Vanperdung/Project_2/README.md

# PROJECT 2 - SMARTHOME
## DEV - [VANPERDUNG](https://www.facebook.com/vanperdung)
