Vanperdung/Project_2/Firmware/Note.txt

Phân biệt chức năng của thiết bị khi Provisioning?
 => How can Provisioner get and parse the Composition Data of nodes through Configuration Client Model?
