Vanperdung/Project_2/Doc/Model.docx

### 1.1. Time Server

Time Server model là root model, khi Time Server model ở một element thì Time Setup Server model cũng phải ở element đó.

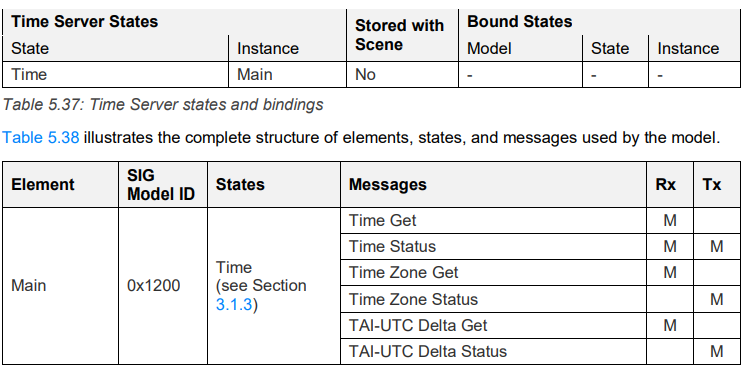
[picture p28: figure]

### 1.2. Time Setup Server

Time Setup Server
