Vanperdung/Project_2/Doc/315151084_661071245694561_7688606577452205725_n.png

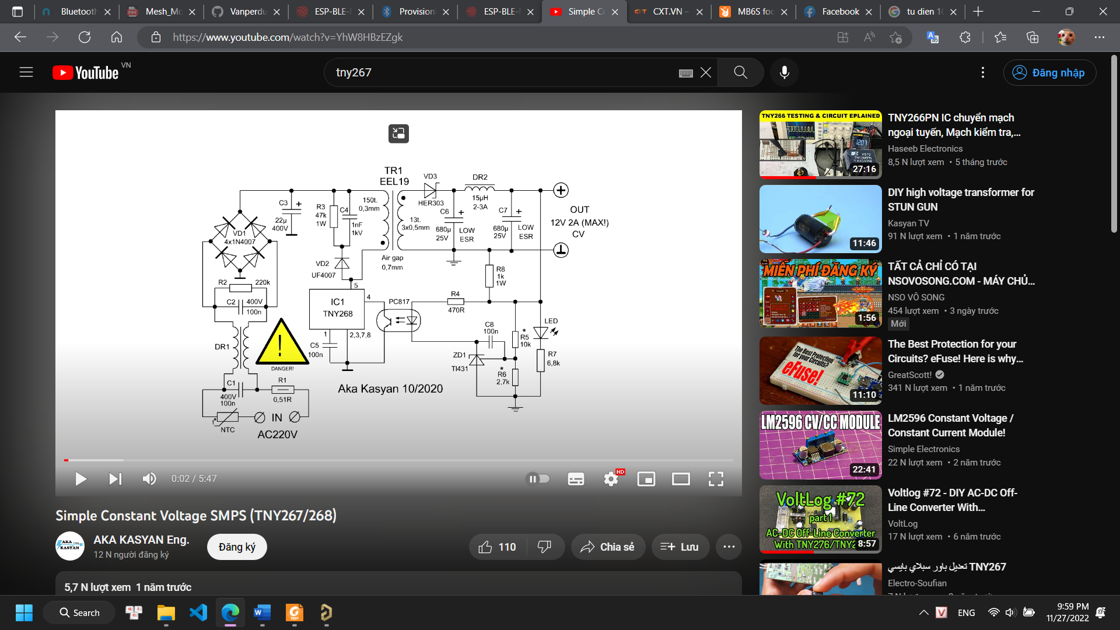
Doc/315151084_661071245694561_7688606577452205725_n.png
