Vanperdung/Project_2/Doc/318385985_421443116750344_1208361178294182225_n.jpg

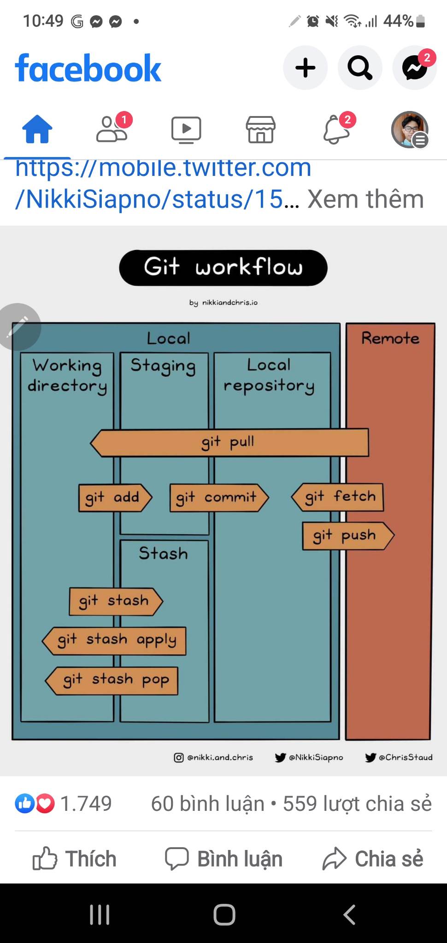
Doc/318385985_421443116750344_1208361178294182225_n.jpg
