Vanperdung/Project_2/Doc/Screenshot 2022-12-20 124549.png

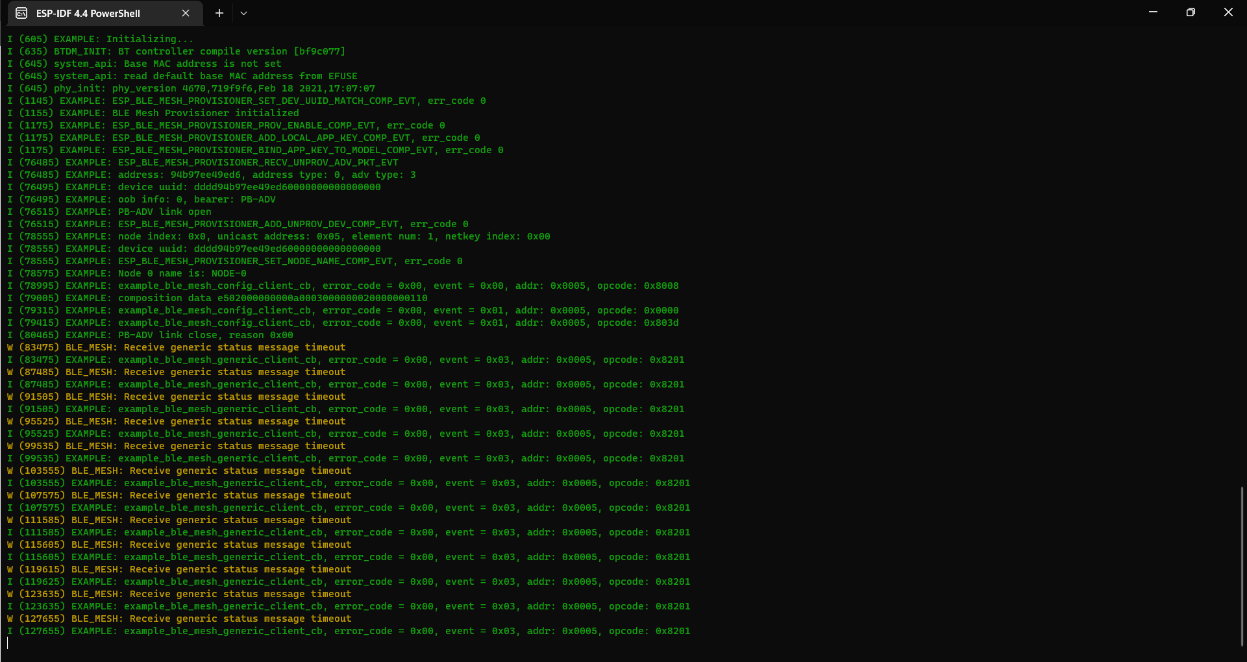
Doc/Screenshot 2022-12-20 124549.png
