Vanperdung/Project_2/Doc/Screenshot 2022-12-20 130242.png

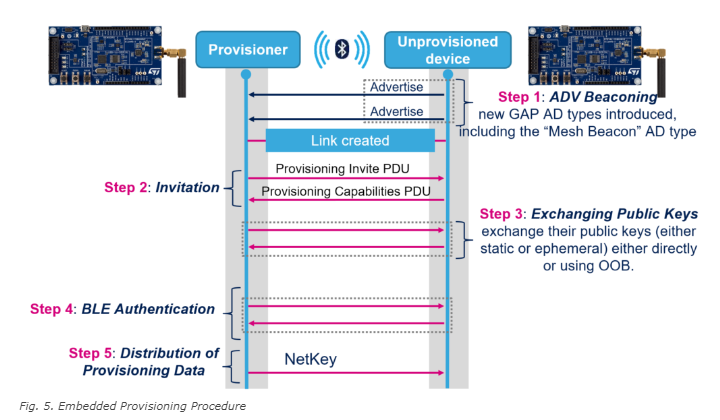
Doc/Screenshot 2022-12-20 130242.png
