Vanperdung/Project_2/Doc/Screenshot 2022-12-21 164502.png

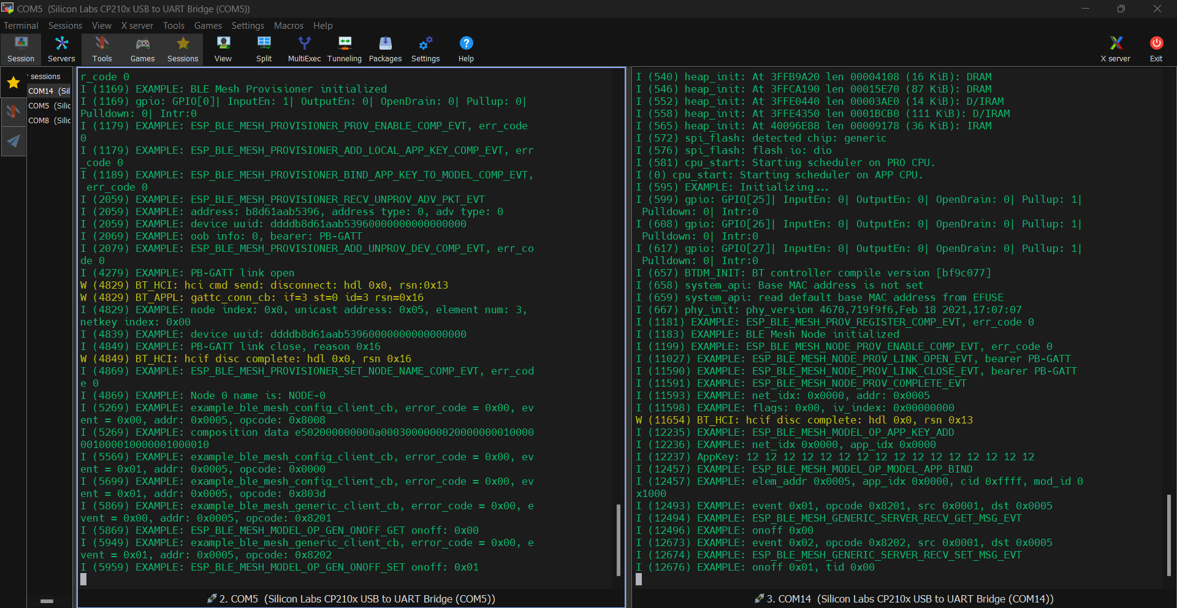
Doc/Screenshot 2022-12-21 164502.png
