Vanperdung/Project_2/Hardware/SmartSwitchV3/Project Outputs for SmartSwitchV3/SmartSwitchV3.xlsx

Comment | Description | Designator | Footprint | LibRef | Quantity
Button 3x4x2.5 |  | B1, B2 | Button 3x4x2.5 | Button 3x4x2.5 | 2
10uF/400V | Polarized Capacitor (Axial) | C1 | C10mm | Cap Pol | 1
1nF/400V | CAP CERAMIC | C2 | 103/2KV | Cap2KV | 1
680uF/16V | Polarized Capacitor (Axial) | C3 | C8mm | Cap Pol | 1
470uF/16V | Polarized Capacitor (Axial) | C4 | C8mm | Cap Pol | 1
0.1uF/275v | Tụ lọc nguồn AC 0.1uf 275v 10mm | C5 | Cap AC filter | Cap AC filter | 1
14D471K | Capacitor Ceramic 2KV | C6 | 103/2KV | Cap2KV | 1
100nF | Capacitor | C7, C8, C9, C11, C13, C15, C18 | CAP_0805 | CapSMD | 7
10uF | Capacitor | C10, C12, C14, C19 | CAP_0805 | CapSMD | 4
30pF | Capacitor | C16, C17, C20, C21 | CAP_0805 | CapSMD | 4
SS14 | Diode Schottky 1N5819 | D1 | DO-214AA(SMB) | Diode SMD | 1
1N4937 | Diode Schottky 1N4937 | D2 | DIO-1AN | Diode SMD | 1
M7 | Dán | D3, D4, D5, D6 | DIODE SMA | Diode M7 ( 4007 ) | 4
TNY264 | IC Power | IC1 | TNY264 | TNY264 | 1
TL431 | Programmable Shunt Regulator | IC2 | qto-92 | TL431 | 1
TTP224 |  | IC3 | TTP224 | TTP224 | 1
Coc_dong |  | JP1, JP2, JP3, JP4, JP5, JP6 | Coc_dong | Coc_dong | 6
Inductor EE8.3 |  | L1 | Inductor EE8.3 | Inductor EE8.3 | 1
22uH | CD73R 22uH 1.23A 7345 | L2 | L_SMD | Inductor | 1
LED | LED Single colour Green and Red | LED1, LED2, LED3, LED4, LED5 | LED-0805-Red | LED | 5
C1815 | NPN 600mW, ECB | Q1, Q2 | SOT23D | 2SC1815 | 2
2N2222 | NPN transistor | Q3, Q4, Q5, Q6 | SOT23 | C1815 HF SMD | 4
200k/2W | Resistor | R1 | RES-1WW | Resistor - SMD | 1
1k | Resistor | R2, R13, R14, R16, R17, R18, R19, R20, R21 | RES-SMD-0805 | Resistor - SMD | 9
1M | Resistor | R3, R4 | RES-SMD-1206 | Resistor - SMD | 2
200R | Resistor | R5 | RES-SMD-0805 | Resistor - SMD | 1
3.3k | Resistor | R6 | RES-SMD-0805 | Resistor - SMD | 1
11k | Resistor | R7 | RES-SMD-0805 | Resistor - SMD | 1
2R/2W | Resistor | R8 | RES-1WW | Resistor - SMD | 1
10k | Resistor | R9, R10, R11, R12, R15 | RES-SMD-0805 | Resistor - SMD | 5
Relay_HF32 |  | RL1, RL2, RL3, RL4 | HF32F | Relay_HF32 | 4
Transformer EE12.7 |  | Transf1 | Transformer EE12.7 | Tranformer EE16 | 1
Diode Bridge Flate | Diode Bridge | U1 | DB207S | Diode Bridge Flate | 1
OPTO PC817 SMD | Single Opto | U2 | SOP4 | OPTO PC817 SMD | 1
ESP32-WROOM-32 | Bluetooth, WiFi Transceiver Module 2.4GHz ~ 2.5GHz Surface Mount | U3 | MODULE_ESP32-WROOM-32 | ESP32-WROOM-32 | 1
CH340C | USB to serial chip CH340 | U4 | SO016 | CH340C | 1
LM1117-ADJ | 800mA Low-Dropout Linear Regulator | U5 | LM1117-SOP | LM1117-ADJ | 1
USB Micro 5p DIP | USB Type B | USB1, USB2 | USB Micro 5p DIP | USB Micro 5p DIP | 2
