Vanperdung/Project_2/Hardware/GatewayV2/Project Outputs for GatewayV2/GatewayV2.xlsx

Comment | Description | Designator | Footprint | LibRef | Quantity
ANTENA | Generic Antenna | AN1 | DE ANTEN SMA CONG | ANTEN SMA CONG | 1
Button 3x4x2.5 |  | B1, B2, B3 | Button 3x4x2.5 | Button 3x4x2.5 | 3 | x
10uF | Capacitor | C1, C3, C6 | CAP_0805 | CapSMD | 3 | x
100nF | Capacitor | C2, C4, C5, C13, C14 | CAP_0805 | CapSMD | 5 | x
10uF/400V | Polarized Capacitor (Axial) | C7 | C10mm | Cap Pol | 1 | x
1nF/400V | CAP CERAMIC | C8 | 103/2KV | Cap2KV | 1 | x
14D471K | Capacitor Ceramic 2KV | C9 | 103/2KV | Cap2KV | 1 | x
0.1uF/275v | Tụ lọc nguồn AC 0.1uf 275v 10mm | C10 | Cap AC filter | Cap AC filter | 1 | x
680uF/16V | Polarized Capacitor (Axial) | C11 | C8mm | Cap Pol | 1 | x
470uF/16V | Polarized Capacitor (Axial) | C12 | C8mm | Cap Pol | 1 | x
SS14 | Diode Schottky 1N5819 | D1 | DO-214AC(SMA) | Diode SMD | 1 | x
1N4937 | Diode Schottky 1N4937 | D2 | DIO-1AN | Diode SMD | 1 | x
MB6S |  | IC1 | MB6S | MB6S | 1 | x
TNY264 | IC Power | IC2 | TNY264 | TNY264 | 1 | x
TL431 | Programmable Shunt Regulator | IC3 | qto-92 | TL431 | 1 | x
KF2 |  | J1 | KF2-5.08T | KF2 | 1 | x
Inductor EE8.3 |  | L1 | Inductor EE8.3 | Inductor EE8.3 | 1 | x
22uH | CD73R 22uH 1.23A 7345 | L2 | L_SMD | Inductor | 1 | x
LED | LED Single colour Green and Red | LED1, LED2, LED3 | LED-0805-Red | LED | 3 | x
C1815 | NPN 600mW, ECB | Q1, Q2 | SOT23D | 2SC1815 | 2 | x
10k | Resistor | R1, R2, R4, R6, R7, R16 | RES-SMD-0805 | Resistor - SMD | 6 | x
1k | Resistor | R3, R5, R12 | RES-SMD-0805 | Resistor - SMD | 3 | x
2R/2W | Resistor | R8 | RES-1WW | Resistor - SMD | 1 | x
1M | Resistor | R9, R11 | RES-SMD-1206 | Resistor - SMD | 2 | x
200k/2W | Resistor | R10 | RES-1WW | Resistor - SMD | 1 | x
200R | Resistor | R13 | RES-SMD-0805 | Resistor - SMD | 1 | x
3.3k | Resistor | R14 | RES-SMD-0805 | Resistor - SMD | 1 | x
11k | Resistor | R15 | RES-SMD-0805 | Resistor - SMD | 1
Transformer EE12.7 |  | Transf1 | Transformer EE12.7 | Tranformer EE16 | 1
LM1117-ADJ | 800mA Low-Dropout Linear Regulator | U1 | LM1117-SOP | LM1117-ADJ | 1 | x
ESP32-WROOM-32 | Bluetooth, WiFi Transceiver Module 2.4GHz ~ 2.5GHz Surface Mount | U2 | MODULE_ESP32-WROOM-32 | ESP32-WROOM-32 | 1
CH340C | USB to serial chip CH340 | U3 | SO016 | CH340C | 1 | x
OPTO PC817 SMD | Single Opto | U4 | SOP4 | OPTO PC817 SMD | 1 | x
USB Micro 5p DIP | USB Type B | USB1 | USB Micro 5p DIP | USB Micro 5p DIP | 1 | x
