Vanperdung/Project_2/(list of files, drawings)

Other design files:
Hardware/Gateway/ES8388.SchDoc
Hardware/Gateway/ESP32.SchDoc
Hardware/Gateway/Gateway.PrjPcb
Hardware/Gateway/GatewayV1.PcbDoc
Hardware/Gateway/Power.SchDoc
Hardware/GatewayV2/ESP32.SchDoc
Hardware/GatewayV2/GatewayV2.PrjPcb
Hardware/GatewayV2/Power.SchDoc
Hardware/SmartSwitchV3/SmartSwitchV3.PcbDoc
Hardware/SmartSwitchV3/SmartSwitchV3.PrjPcb
Hardware/SmartSwitchV3/SmartSwitchV3.SchDoc
Hardware/Switch/Switch.PcbDoc
Hardware/Switch/Switch.PcbLib
Hardware/Switch/Switch.PrjPcb
Hardware/Switch/Switch.SchDoc
Hardware/Switch/Switch_V1.PcbDoc
Hardware/Switch_MCU/ESP32.SchDoc
Hardware/Switch_MCU/MCU.PcbDoc
Hardware/Switch_MCU/Switch_MCU.PrjPcb
Hardware/Switch_MCU/TPS5430.SchDoc
Hardware/Switch_MCU/TTP224.SchDoc
Hardware/SwitchV2/Switch.SchDoc
Hardware/SwitchV2/SwitchV2.PcbDoc
Hardware/SwitchV2/SwitchV2.PrjPcb
Hardware/Test/PCB2.PcbDoc
Hardware/Test/Sheet1.SchDoc
Hardware/Test/Sheet2.SchDoc
Hardware/Test/Test.PrjPcb
