Vanperdung/Project_2/Firmware/gateway/main/fota.c

/**
 * @file fota.c
 * @author Vanperdung (dung.nv382001@gmail.com)
 * @brief
 * @version 0.1
 * @date 2023-01-03
 *
 * @copyright Copyright (c) 2023
 *
 */

#include "freertos/FreeRTOS.h"
#include "freertos/task.h"
#include "freertos/event_groups.h"
#include "freertos/queue.h"
#include "freertos/ringbuf.h"
#include "freertos/semphr.h"

#include "nvs_flash.h"

#include "esp_ble_mesh_defs.h"
#include "esp_ble_mesh_common_api.h"
#include "esp_ble_mesh_provisioning_api.h"
#include "esp_ble_mesh_networking_api.h"
#include "esp_ble_mesh_config_model_api.h"
#include "esp_ble_mesh_generic_model_api.h"
#include "esp_log.h"
#include "esp_bt.h"
#include "esp_bt_main.h"
#include "esp_gap_ble_api.h"
#include "esp_bt_device.h"
#include "esp_wifi.h"
#include "esp_smartconfig.h"
#include "mqtt_client.h"
#include "esp_spiffs.h"
#include "esp_ota_ops.h"
#include "esp_http_client.h"
#include "esp_https_ota.h"
#include "esp_tls.h"

#include "driver/gpio.h"

#include "cJSON.h"
#include "mqtt.h"
#include "wifi_sta.h"
#include "button.h"
#include "ble_mesh_user.h"
#include "smartconfig.h"
#include "common.h"
#include "spiffs_user.h"
#include "fota.h"

static const char *TAG = "FOTA";
esp_mqtt_client_handle_t client;
extern char version[10];
extern char topic_commands_set[50];
extern char topic_commands_get[50];
extern char topic_commands_status[50];
extern char topic_commands_heartbeat_node[50];
extern char topic_commands_heartbeat_gateway[50];
extern char topic_commands_network[50];
extern char topic_commands_process[50];
extern char topic_commands_version[50];
extern char topic_commands_fota[50];
extern char topic_commands_group[50];
extern char topic_commands_provision[50];
extern status_red_t status_red;
extern status_blue_t status_blue;

extern const uint8_t github_cert_pem_start[] asm("_binary_git_ota_pem_start");
extern const uint8_t github_cert_pem_end[] asm("_binary_git_ota_pem_end");

esp_err_t ota_event_handler(esp_http_client_event_t *evt)
{
    switch (evt->event_id)
    {
    case HTTP_EVENT_ERROR:
        ESP_LOGD(TAG, "HTTP_EVENT_ERROR");
        break;
    case HTTP_EVENT_ON_CONNECTED:
        ESP_LOGD(TAG, "HTTP_EVENT_ON_CONNECTED");
        break;
    case HTTP_EVENT_HEADER_SENT:
        ESP_LOGD(TAG, "HTTP_EVENT_HEADER_SENT");
        break;
    case HTTP_EVENT_ON_HEADER:
        ESP_LOGD(TAG, "HTTP_EVENT_ON_HEADER, key = %s, value = %s", evt->header_key, evt->header_value);
        break;
    case HTTP_EVENT_ON_DATA:
        ESP_LOGD(TAG, "HTTP_EVENT_ON_DATA, len = %d", evt->data_len);
        break;
    case HTTP_EVENT_ON_FINISH:
        ESP_LOGD(TAG, "HTTP_EVENT_ON_FINISH");
        break;
    case HTTP_EVENT_DISCONNECTED:
        ESP_LOGD(TAG, "HTTP_EVENT_DISCONNECTED");
        break;
    }
    return ESP_OK;
}

void fota_task(void *param)
{
    char ota_url[100] = {0};
    strcpy(ota_url, (char *)param);
    ESP_LOGI(TAG, "FOTA start, url: %s", ota_url);
    status_blue = FOTA;
    esp_http_client_config_t ota_cfg = {
        .url = ota_url,
        .event_handler = ota_event_handler,
        .keep_alive_enable = true,
        .cert_pem = (char *)github_cert_pem_start,
    };
    esp_err_t ret = esp_https_ota(&ota_cfg);
    if (ret == ESP_OK)
    {
        ESP_LOGI(TAG, "OTA done, restarting...");
        esp_mqtt_client_publish(client, (char *)topic_commands_process, "{\"action\":\"fota\",\"process\":\"100\"}", strlen("{\"action\":\"fota\",\"process\":\"100\"}"), 0, 0);
        vTaskDelay(1000 / portTICK_RATE_MS);
        esp_restart();
    }
    else
    {
        ESP_LOGE(TAG, "OTA failed...");
    }
}
