Vanperdung/Project_2/(commit log)

2022-11-27 push sche gateway
    [Gateway.PrjPcb, GatewayV1.PcbDoc, Power.SchDoc]
2022-11-29 push pcb gateway 50%
    [ESP32.SchDoc, GatewayV1.PcbDoc, Power.SchDoc]
2022-11-30 push pcb gateway
    [ESP32.SchDoc, Gateway.PrjPcb, Power.SchDoc]
2022-12-13 up switch pcb
    [ESP32.SchDoc, Switch.PcbDoc, Switch.PcbLib, Switch.PrjPcb, Switch.SchDoc, Switch_MCU.PcbDoc, Switch_MCU.PrjPcb, TPS5430.SchDoc]
2022-12-26 26122022 provisioner done
    [partitions4M.csv]
2023-01-01 01012023 pcb done
    [ESP32.SchDoc, MCU.PcbDoc, Sheet.SchDoc, SwitchV2.PcbDoc, SwitchV2.PrjPcb, Switch_MCU.PrjPcb, TPS5430.SchDoc, TTP224.SchDoc]
2023-01-02 provision feature done 02012023
    [partitions4M.csv]
2023-01-04 fix bug store provision node info 04012023
    [ble_mesh_user.c, ble_mesh_user.h, main.c]
2023-01-12 custom provisioning operation in gateway and switch 12012023
    [MCU.PcbDoc, partitions4M.csv]
2023-01-25 95% 25012023
    [SmartSwitchV3.PcbDoc, SmartSwitchV3.PrjPcb, partitions4M.csv]
2023-01-26 26012023 fix delete node
    [ble_mesh_user.c, ble_mesh_user.h, mqtt.c]
2023-01-26 26012023 add softAP and webserver
    [ESP32.SchDoc, SmartSwitchV3.PrjPcb, SmartSwitchV3.SchDoc]
2023-03-11 11032023
    Update report
    [SmartSwitchV3.xlsx, partitions4M.csv]
